pli49/Final-Year-Project/README.md

# ENEL400-ENMT401-EN14

My contribution for this project was desplayed in the Pengcheng-Liu-Mic-part folder.
