pli49/Final-Year-Project/Reports/Final Report/AppendixA.tex

\begin{figure}[H]
\centering
\noindent 
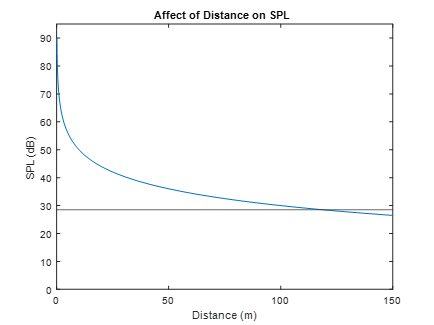
[picture p1: Reports/Final Report/images/sim1.png]

\caption{Attenuation with distance}
\label{fig:distAtt}
\end{figure}

\begin{figure}[H]
\centering
\noindent 
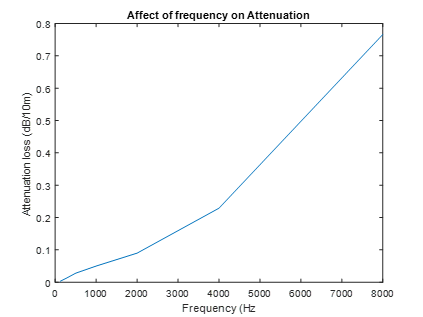
[picture p2: Reports/Final Report/images/sim2.png]

\caption{Attenuation due to atmosphere}
\label{fig:distAtt}
\end{figure}

\begin{figure}[H]
\centering
\noindent 
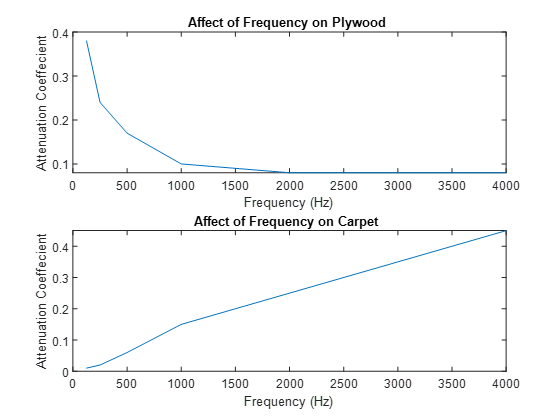
[picture p3: Reports/Final Report/images/sim3.png]

\caption{Attenuation due to materials}
\label{fig:distAtt}
\end{figure}
