pli49/Final-Year-Project/Reports/Final Report/AppendixB.tex

\begin{table}[H]
\captionsetup{singlelinecheck = false, format= hang, justification=raggedright, font=footnotesize, labelsep=space}
\caption{Limiting factors of frequency}
\begin{adjustbox}{max width=\textwidth}
\begin{tabular}{p{7.95cm}p{7.95cm}}
\hline
\multicolumn{1}{|p{7.95cm}}{Limiting factor } & 
\multicolumn{1}{|p{7.95cm}|}{Frequency Constraint} \\ 
\hline
\multicolumn{1}{|p{7.95cm}}{Speaker} & 
\multicolumn{1}{|p{7.95cm}|}{>700 Hz and <11 kHz} \\ 
\hline
\multicolumn{1}{|p{7.95cm}}{Noise } & 
\multicolumn{1}{|p{7.95cm}|}{>1600 Hz} \\ 
\hline
\multicolumn{1}{|p{7.95cm}}{Porous Materials} & 
\multicolumn{1}{|p{7.95cm}|}{<250 Hz} \\ 
\hline
\multicolumn{1}{|p{7.95cm}}{Reflective Material} & 
\multicolumn{1}{|p{7.95cm}|}{>1 kHz} \\ 
\hline
\multicolumn{1}{|p{7.95cm}}{Air Attenuation } & 
\multicolumn{1}{|p{7.95cm}|}{<15 kHz} \\ 
\hline
\end{tabular}
\end{adjustbox}
\label{tab:limiting_factors_frequency}
\end{table}
