pli49/Final-Year-Project/Reports/Final Report/AppendixC.tex

\begin{figure}[H]
\centering
\noindent 
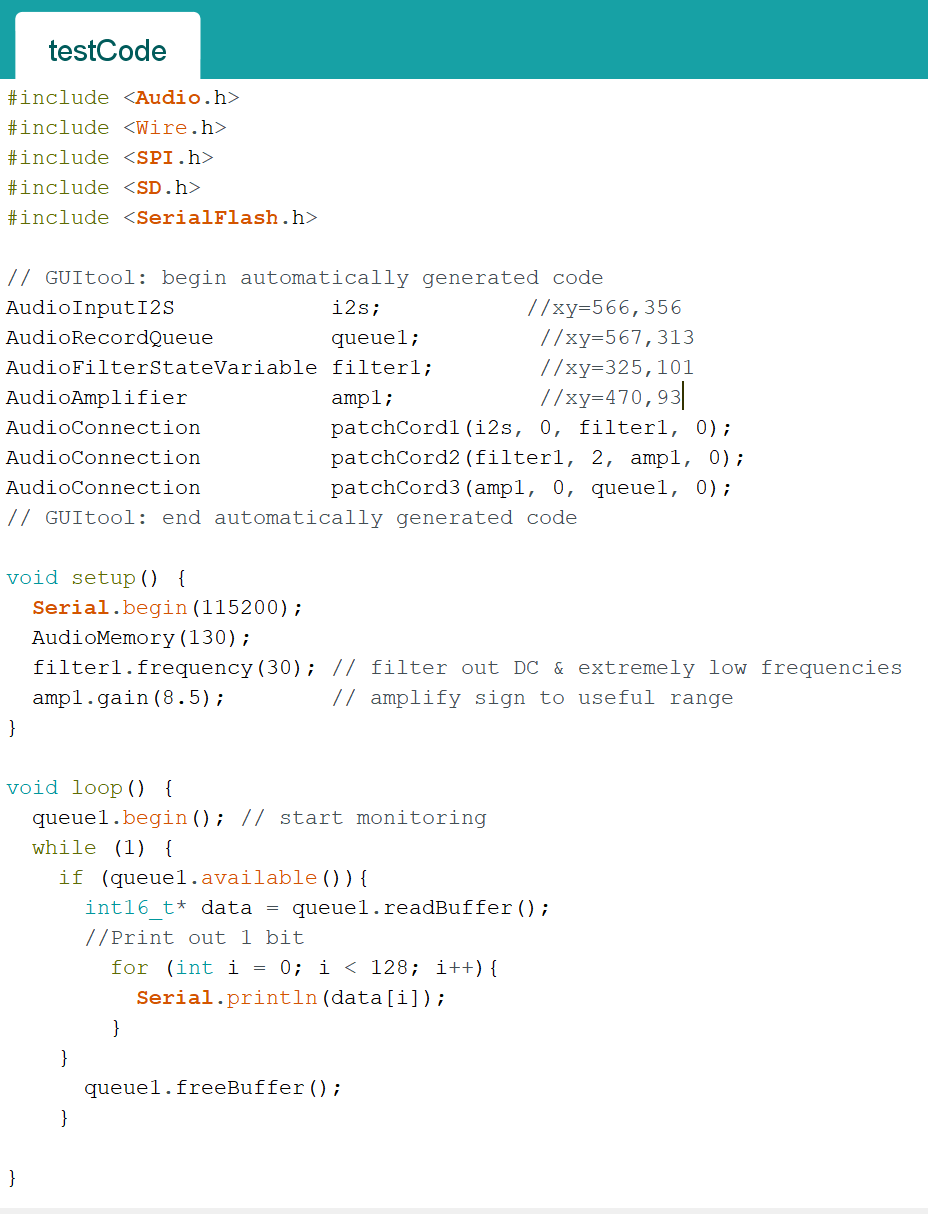
[picture p4: Reports/Final Report/images/testCode.PNG]

\caption{Test Code using Queue function}
\label{fig:testCode}
\end{figure}
