pli49/Final-Year-Project/Speaker/Final Report/Laurence_Section.tex

% !TeX spellcheck = en_AU-EnglishAustralia
% Preamble
\documentclass[12pt, a4paper]{article}
\usepackage[utf8]{inputenc}
%\usepackage[english]{babel}

\usepackage{indentfirst}
\usepackage{rotating, graphicx}
\usepackage{geometry}
\usepackage{hyperref}
\usepackage{amsmath}
\usepackage{amssymb}
\usepackage{gensymb}
\usepackage{caption}
\usepackage{array}
\newgeometry{vmargin={30mm}}
\usepackage[toc,page]{appendix}

\setlength{\oddsidemargin}{0mm}
\setlength{\evensidemargin}{-14mm}
\setlength{\marginparwidth}{0cm}
\setlength{\marginparsep}{0cm}
\setlength{\headheight}{0mm}
\setlength{\topmargin}{2mm}
\setlength{\headsep}{0cm}
\setlength{\textheight}{240mm}
\setlength{\textwidth}{160mm}
\setlength{\topskip}{0mm}
\setlength{\footskip}{10mm}
\setlength{\parindent}{8ex}

\title{The Speaker System}	
\author{Laurence Prins}
\date{25.10.2021}
\usepackage[style=ieee]{biblatex}
\addbibresource{References.bib}

\begin{document}
\section{Exec Sum}
Office workers can spend up to ninety-thousand hours of their life at work. It is important that these office environments are as ergonomic as possible for the sake of the workers’ health and well-being. Wellnomics develop systems for improving office space workers health and well-being. Wellnomics are developing a device that will attempt to map an indoor space using audio technology. Use of the device will allow better understanding of how to structure the office layout for improving the environment. \\

The goal of the project was to lay the foundations for using audio technology to measure distance. The user requirements were: the system must use sound to measure distance, a model should be built to estimate device position, the devices should be low cost, the devices should be low power, the devices should be small and the designed system should be robust to noise. \\

The work was split up into four areas: the sound to produce, the speaker system, the microphone, and the area mapping. Each of these areas required research, simulations and prototyping to develop the final systems. \\

Research into the sound to play found the most common forms of noise within an office space, the absorbtion and reflection of various office space materials and the frequency response of the speaker and microphone. Using the information it was concluded that the best frequency range for the system is between 1600Hz and 11kHz. \\

A system for the speaker needed to be designed such that the output was a loud and accurate tone. Development of the speaker system involved production of hardware for making the tone, and development of the software to produce sinusoids. The final system can play single tones and linear sweeps of between 600Hz and 20kHz, the full range of the speaker. \\

The microphone used in this project is a small I2S MEMs microphone. Research was first conducted on how to make the microphone work and understand and use the output. Methods were theorised for conducting distance measurements with the microphone. Unfortunately, due to the speed of the FFT there would be an uncertainty of 3.773 metres. \\

Work was conducted on how to measure distance. It was concluded that the best method is to use a linear FM sweep and use of convolution to detect the start of the waveform. Devices utilising a "virtual wall" could then asynchronously measure distance. Simulations were done on generation of 2D and 3D mesh generation for mapping the devices once measurements are obtained. \\

Although no distance measurements were conducted using the devices in this project, the framework is all set up for future development. \\
\pagebreak
\section{Laurence Prins}
\subsection{Introduction and Background}
A key aspect of measuring distance with sound is the ability to reliably reproduce a high power and accurate audio tone. The tone produced should have a high SPL output such that it can be detected from far away, and should be accurate such that the tone can be extracted at the receiver in the midst of background noise. The designed system should also have an easy to use control system for testing a wide range of tones. This section of the report covers the development of the speaker system, looking at the speaker and amplifier, the creation of a sine wave and code development for controlling the system.\\
\subsection{Hardware}
\subsubsection{Speaker}
The used speaker for the system is the AS01508MS-SP11-WP-R as it was supplied by the sponsor. This has the specifications shown in Table \ref{tab:L_speakerSpecs}.  The system designed for the speaker needed to supply at least 0.7W, and to get the highest SPL from the speaker it needs a supply of at least 1W. Running the speaker for long periods at the 1W input power could cause damage, however the speaker is not be producing tones for long so this would be irrelevant for the design. \\

Other characteristics of importance for the speaker include the impedance and sensitivity, which are both functions of frequency. Each component selected in the design for the speaker system took into account this frequency response, selecting components with a similar frequency response. \\

\begin{table} [!htb]
	\caption{Key speaker specifications, source: \cite{speakerDatasheet}}
	\label{tab:L_speakerSpecs}
	\centering
	\begin{tabular}{ |c|c|c| }
		\hline
		Parameter & Value & Unit \\ 
		\hline
		Rated Input Power & 0.7 & W \\ 
		Max Input Power & 1 & W \\ 
		Impedance & 8 $\pm$ 15\% & Ohms \\
		Sensitivity (SPL@2V/10cm) & 89 $\pm$ 3 & dB \\
		\hline
	\end{tabular}
\end{table}

\subsubsection{Amplifier}
The output from the MCU is a 3.3V peak waveform with a 0.04mA current, this is a much lower power output than what is needed by the speaker. An amplifier is used to increase the power of the output waveforms from the MCU. \\

There were several options considered for the amplifier, class A, class B, class AB and class D each with their own advantages and disadvantages. Ultimately, the best amplifier for the system is the class D amplifier. This is because it is more efficient than the other options (theoretically up to 100\%), allowing the speaker to be driven to its peaks. Efficiency is also important to meet the low power draw user requirement of the system. \\

The chosen amplifier is the class D PAM8403 audio amplifier with the specifications shown in Table \ref{tab:L_ampSpecs}. The amplifier was chosen as it is up to 90\% efficient outputting up to 1.4W for the 8$\Omega$ load. The amplifier gets its efficiency as it uses differential outputs and sinusoidal PWM to pull each leg of the speaker between 0 and Vcc, working in an operation like an H-bridge. \\
\begin{table} [!htb]
	\caption{Key amplifier specifications, source: \cite{amplifierDatasheet}}
	\label{tab:L_ampSpecs}
	\centering
	\begin{tabular}{ |c|c|c| } 
		\hline
		Parameter & Rating & Unit \\ 
		\hline
		Input Voltage & -0.3 to +0.3 & V \\ 
		Supply Voltage & 5.0 & V \\ 
		Output Power for 8 $\Omega$ Load and 5V Supply & 1.4 & W \\
		\hline
	\end{tabular}
\end{table}

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

The MCU cannot easily produce a sinusoidal tone as it does not include a digital to analogue converter. To get around this there were several options considered including purchasing an off-board DAC, purchasing a new MCU, or using code to produce sinusoidal PWM. Ultimately, the best option was to use parts that were easily obtained to meet the low-cost user requirement, that meant using sinusoidal PWM. By generating a sinusoidal PWM signal, and passing the waveform through a low pass filter, a good estimate of a sine wave can be produced. \\
\subsubsection{Generating Sinusoidal PWM}
\label{sec:L_Sinusoidal PWM}
First the sinusoidal PWM waveform needs to be generated at the MCU output pin. This was done using code. A continuous sinusoidal waveform of period, $T_s$, is split up into $L$ discrete intervals. At each of these intervals, the duty cycle increased or decreased by $\frac{100\%}{2^m}$ where m is the resolution of the PWM generator. 100\% duty cycle is equal to $2^m - 1$, which is set when the sinusoid is at its peak, and the minimum value corresponding to 0\% duty cycle is 0 which is set when the sinusoid is at its minimum. The 50\% duty cycle is then $(2^m-1)/2$ which is the cross-over point of the sinusoid. These values are put into a sine look up table of length L. Figure \ref{fig:L_Sinusoidal_PWM} shows the sinusoid being split up into L discrete intervals and the corresponding duty cycles. \\

\begin{figure} [!htb]
	\hfill\hspace{\fill}
	\caption{Sinusoidal PWM generation}
	\label{fig:L_Sinusoidal_PWM}
\end{figure}
To set the rate which the LUT is indexed, a counter and an interrupt timer is used. At each interrupt period, $\tau$, a step of $\Delta$ is added to the current counter value. Once the counter exceeds the maximum counter value, $M$, the counter is reset with remainder carried and the LUT is indexed by one for each amount of $\Delta$ the count is above M. Figure \ref{fig:L_Counter} shows the visualisation of the counter. 
\begin{figure} [!htb]
	\captionsetup{justification=centering}
	\hfill\hspace{\fill}
	\caption{Counter with max value M, it takes n$\Delta$ counts to exceed M}
	\label{fig:L_Counter}
\end{figure}

It takes $n$ lots of $\Delta$ to exceed $M$ therefore:
\begin{equation}
	n\times\Delta \ge M \implies n = \frac{M}{\Delta}
	\label{eqn:M/D}
\end{equation}
The interrupt is being called every $\tau$ seconds and so the time it takes per increment of the LUT is $n\times T$. There are $L$ elements in the LUT so, the period of the sine wave is thus:
\begin{equation}
	T_s = n\times \tau\times L
\end{equation}
Which can be written in terms of frequency:
\begin{equation}
	f_s = \frac{1}{n\tau L}
\end{equation}
And in terms of the step size by substituting equation \ref{eqn:M/D}:
\begin{equation}
	f_s(\Delta) = \frac{\Delta}{M\tau L}
\end{equation}

The frequency of the output sine is now a function of the step size $\Delta$ and thus sinusoidal waveforms of selectable frequencies can be produced. The equation can be re-arranged to find any values of $\Delta$ that gives a corresponding sinusoidal output frequency, which is exactly how the code decides the output frequency. \\

The values of M and $\tau$ were determined through experimentation, where if the interrupt rate was too high then the interrupt function is too slow and so the frequency gets capped at less than 20kHz. Having this value too high would result in the same problem. The value for $f_{PWM}$ was chosen as such as it allows the PWM frequency to be fully filtered out leaving behind just the sinusoidal component. The value of m is dependent on the PWM frequency and vice-versa, however the Teensy can re-map values passed to it, so the selection of m is irrelevant and a value of 8. Finally, the LUT was selected as $2^8$ to match the PWM resolution used. The values selected for the sinusoidal PWM generation parameters are summarised in Table \ref{tab:L_sinusoidalPWM}.\\
\begin{table} [!htb]
	\caption{Parameters used for sinusoidal PWM generation}
	\label{tab:L_sinusoidalPWM}
	\centering
	\begin{tabular}{ |c|c|c|c| }
		\hline
		Parameter & Description & Value & Units \\ 
		\hline
		M & Counter Maximum & 100 & - \\ 
		$\tau$ & Interrupt Period & 5 & $\mu$s \\ 
		L & LUT Size & $2^8$ & - \\
		$f_{PWM}$ & PWM Frequency & $2^8\times f_s$ & Hz\\
		m & PWM Resolution & 8 & - \\
		\hline
	\end{tabular}
\end{table}

\subsubsection{Filtering the Sinusoidal PWM Signal}
\label{sec:L_Low_Pass_Filter}
To filter the sinusoidal PWM signal, a second order LC Butterworth filter is used. The filter connects to the output pin on the MCU as shown in Figure \ref{fig:L_LPF}. The values selected for the LPF gives the filter a cut-off frequency of 28kHz. 28kHz was chosen as it higher than the maximum frequency of the speaker but is also able to fully filter out the PWM carrier frequency. \\

The filter also contains a 67$\mu$F electrolytic capacitor. This is because the output sinusoidal PWM waveform generated is shifted with a maximum value of 3.3V and a minimum value of 0V. To get the speaker driven to the peaks in its motion it needs to be fed a waveform centred about DC. So using a DC blocking capacitor shifts the output sine waveform from the LPF back to DC. The capacitor and the 10k$\Omega$ resistor at the entrance of the amplifier form a passive bandpass filter with a passband of between 0.237Hz and 297Hz depending on the position of the variable resistor wiper, and a stopband of 28kHz. \\
\begin{figure} [!htb]
	\hfill\hspace{\fill}
	\caption{Second order LC low pass filter with a cut-off frequency of 28kHz}
	\label{fig:L_LPF}
\end{figure} 

\subsubsection{Linear FM Sweep (Chirp)}
\label{sec:L_Chirps}
The speaker is required to play a linear FM sweep as used in the convolution method of measuring distance. To produce a linear FM sweep, or chirp, the continuous function is described by:
\begin{equation}
	f(t) = ct + f_0
	\label{eqn:Chirp1}
\end{equation}
Where $f_0$ is the initial frequency, and c is the chirp rate, calculated as:
\begin{equation}
	c = \frac{f_1 - f_0}{T_c}
\end{equation}
Where $f_1$ is the final frequency and $T_c$ is the sweep or chirp time. \\

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

To differentiate serial inputs, the function needs to be input between $<$ and $>$. The code waits till it sees the $<$ and will extract all the data from between the two arrows. Using this method allows the user to run several inputs at once in one serial line. When it comes to playing a tone, this allows the ability to run multiple one after the other essentially chaining waveforms together. \\

\subsubsection{Waveforms}
The code loop is combined with "waveforms", where each waveform is a struct stored in a singly linked list. Each waveform contains an an initial frequency, a final frequency, a wave time and a shape (p for square or s for sine). When the waveform is created it is given a unique identifier and is stored at the head of a singly linked list shown in Figure \ref{fig:L_Waveforms}. Waveforms in the list can be displayed, edited, deleted, played or even looped using functions outlined in Table \ref{tab:L_transmitterInteractions} in Appendix \ref{sec:l_append}. \\

\begin{figure} [!htb]
	\hfill\hspace{\fill}
	\caption{Waveforms in a linked list data structure}
	\label{fig:L_Waveforms}
\end{figure} 

Waveforms allow a convenient method of playing a wide range of tones quickly. For example, the user can create 10 waveforms of increasing frequency and test each one. After testing each one they could identify the best for the use case and keep on testing that one, typing in an identifier instead of each waveform property each time. For quick testing however, functions were created which allows users to simply input all the waveform properties without having to create a waveform. The play tone functions are outlined in Table \ref{tab:L_toneInteractions} in Appendix \ref{sec:l_append}. \\

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

\begin{figure} [!htb]
	\captionsetup{justification=centering}
	\hfill\hspace{\fill}
	\caption{Speaker hardware setup, the labelled sections are - A: Teensy 4.0 MCU dev board, B: LPF and variable resistor volume knob, C: class D audio amplifier breakout board, D: Speaker}
	\label{fig:L_Hardware}
\end{figure} 

A wide range of tones were tested with the speaker, both square and sinusoidal. The system was capable of playing square tones up to 9kHz but not above as the extra harmonics were fully filtered. As the best range of the speaker is at 10kHz, this was the most tested waveform. The following results section shows the generation of a 10kHz tone from transmitter to receiver. \\

The waveform is first created and played shown in Figure \ref{fig:L_Create_Waveform}. The 1280 number shown is the step size required to play the 10kHz tone. The sinusoidal PWM waveform is then generated at the audio output pin shown in Figure \ref{fig:L_Create_Waveform}. The waveform has a lot of ripple as the PWM frequency is so high (2.54MHz). \\

The waveform is then passed through the LPF and DC blocking capacitor resulting in the waveforms shown in Figure \ref{fig:L_Shifted_Waveform}. \\

The waveform then travels through the medium. Figure \ref{fig:L_Output} shows the spectrum of the output audio waveform generated in MATLAB and the power spectral density of the output waveform generated using an auto regressive Yule-Walker method. The audio clip was recorded in the students bedroom on a quiet afternoon, as such there is little noise. \\

\begin{figure} [!htb]
	\captionsetup{justification=centering}
	\hfill\hspace{\fill}
	\hspace{\fill}
	\caption{Left: A 10kHz tone is created and given the unique identifer "0". The waveform is then played using the play function: $"<p(0)>"$. Right: The waveform as generated at the audio output pin.}
	\label{fig:L_Create_Waveform}
\end{figure}

\begin{figure} [!htb]
	\captionsetup{justification=centering}
	
	
	\caption{Left: the shifted waveform as seen at the exit of the LPF. Right: the waveform as seen at the exit of the DC blocking capacitor}
	\label{fig:L_Shifted_Waveform}
\end{figure}

\begin{figure} [!htb]
	\captionsetup{justification=centering}
	
	
	\caption{Left: the output audio spectrum. Right: the output power spectral density (PSD)}
	\label{fig:L_Output}
\end{figure}

\pagebreak
\subsection{Discussion}
The objective for the speaker system was to produce a system that can play a loud and accurate tone. Control for the system should be easily used to produce any desired tone within the speakers range. The system developed should meet as many of the user requirements as possible. \\

The system for generating waveforms works well. By utilising waveforms and using functions from within the serial interface, a wide range of tones were able to be quickly tested. In the testing phase with the other devices, using waveforms allowed ease of talking between devices. Use of waveforms could be useful in final product. The device could play a waveform and if no results are picked up, the device could move on and play another waveform. Devices could also be given unique waveforms, potentially allowing several devices to talk at the same time as each other. \\

The amplifier is a class D amplifier which means that the output is a square waveform. To compensate for this, an additional 2nd order LPF can be added to the legs of the speaker. However, the speaker itself acts as a low pass filter with a cut-off of 20kHz. This means that the only use of the filters will be for reducing electromagnetic interference and as a result were not implemented in the final system for the speaker. To improve on the reliability of the system however, these LPF should be implemented. \\

The final hardware design is big which means it does not meet the small design user requirement. However, as this system was just designed with testing in mind, it serves its purpose. The designed system is ultimately just a prototype and would need to be refined and polished. For future development, it is recommended to construct a PCB. The PCB should also address the use of the variable resistor as the current trim-pot variable resistor requires direct interaction with the hardware. Using a system that can control the output audio using code would be beneficial for further development of the system, allowing for freedom of control of the output audio power. \\

Development of the sinusoidal PWM system also took longer than it should have. It would make more sense in the final product to utilise a DAC chip or a MCU with an onboard DAC. This would result in a more accurate audio waveform which is what is necessary for measuring distance with sound and making the system robust to noise. If a DAC chip had been purchased from the start, that time could have been spent on other areas such as helping other group members on their development. \\

The system is fully capable of playing tones up to 20kHz, which is the full range of the speaker. This is however with a fast MCU with the 5$\mu$s interrupt (200kHz) used in creating the sinusoidal signal. For a slower MCU clock speeds, this might not be possible. As a result it is even more important for slower micros to use an off-board or on board DAC for generating the sinusoidal tone.\\

Most of the output signal is concentrated within the central 10kHz lobe as shown in Figure \ref{fig:L_Output}. The PSD shows this more clearly, where there is peak at lower frequencies due to background noise at the time of recording. Although, since the unit of the PSD is in dB, the noise is completely dominated by the output signal. The speaker system is therefore capable of playing accurate tones as the design requirements. Further testing would need to be conducted on the speaker system to identify the exact limitations of the system. \\

The prototype system for the speaker is complete and the framework has been laid to allow for ease of integration with the rest of the system. \\
\pagebreak
\subsection{For Appendix: Serial Inputs for Speaker System}
\label{sec:l_append}
Table \ref{tab:L_waveformInteractions} shows a list of accepted functions for creating and interacting with waveforms. \\

For example, to create a waveform that plays a 10kHz sinusoidal tone for 1 second, type "$<$n(10000,10000,1000,s)$>$" into the serial interface. This will create a new waveform and give it an identifier. To display the waveforms to find out what identifier the new waveform was given, can then type "$<$d(a)$>$" which will print out the list of waveforms. As this was the first waveform created after the initial one created on startup, typing "$<$p(1)$>$" will play the 10kHz tone. If it was actually desired to have a linear FM sweep between 7kHz to 10kHz over 250 ms, then the waveform can be edited using "$<$e(1,f0,7000,time,250)$>$". Typing "$<$d(a)$>$" will then display the new waveform. Playing the tone now will then play the linear FM sweep between 7kHz and 10kHz over 250ms instead of the 10kHz tone. \\
\begin{table} [!htb]
	\caption{Waveform interaction functions}
	\label{tab:L_waveformInteractions}
	\centering
	\begin{tabular}{ |m{0.25\textwidth}|m{0.35\textwidth}|m{0.4\textwidth}| } 
		\hline
		Serial Command & Description & Inputs \\ 
		\hline
		\hline
		\centering $<n(f0,f1,t,s)>$ & Creates a new waveform, gives it a unique identifier, and stores it at the head of the singly linked waveform list. & f0 = initial frequency [Hz]
		
		f1 = final frequency [Hz].
		 
		t = wave time [s].

		s = waveshape 
		
		[s = sinusoidal, p = square]. \\
		
		\hline
		\centering$<e(i,p1,v1,p2,v2,$
		\centering$…,pn,vn)>$ & Updates the specified waveform with the new values for the specified properties. & i = identifier of wave to edit.
		
		pn = property (f0, f1, time or shape).
		
		vn = new value. \\
		
		\hline
		\centering$<r(i)>$ & Deletes the specified waveform. & i = identifier of wave to remove.
		
		If i = a then deletes all waveforms in the linked list instead. \\
		\hline
		\centering$<d(i)>$ & Prints all the properties of the specified waveform into the serial interface. & i = identifier of wave to display.
		
		If i = a then displays all waveforms in the linked list instead.\\
		\hline
		\centering$<p(i)>$ & Plays the specified waveform through the audio output pin, 
		if f0 $\neq$ f1 then this will play a linear FM sweep between those frequencies. & i = identifier of wave to play. \\
		
		\hline
		\centering$<l(i)>$ & Plays the specified waveform through the audio output pin until the serial reads a new input. & i = identifier of wave to loop. \\
		\hline		
	\end{tabular}
\end{table}
\pagebreak

Table \ref{tab:L_toneInteractions} shows a list of accepted functions for playing tones without using waveforms. \\

For example, to play a 10kHz tone over 1 second, type "$<$pt(10000,10000,1000,s)$>$" will play that tone. Typing "$<$pt(7000,10000,250,s)$>$" will play the linear sweep again. This method allows for quick testing of different waveforms, however requires more typing in the long run. If the user is wanting to repeatedly test a specific tone, they should use a waveform instead. \\
\begin{table} [!htb]
	\caption{Play tone functions}
	\label{tab:L_toneInteractions}
	\centering
	\begin{tabular}{ |m{0.25\textwidth}|m{0.35\textwidth}|m{0.4\textwidth}| } 
		\hline
		Serial Command & Description & Inputs \\ 
		\hline
		\hline
		\centering $<pt(f0,f1,t,s)>$ & Plays a tone with the specified properties through the audio output pin. if f0 $\neq$ f1 then this will play a linear FM sweep between those frequencies. & f0 = initial frequency [Hz]
		
		f1 = final frequency [Hz].
		
		t = wave time [s].
		
		s = waveshape 
		
		[s = sinusoidal, p = square]. \\
		
		\hline
		\centering $<lt(f0,f1,t,s)>$ & Plays a tone with the specified properties through the audio output pin until the serial reads a new input. & f0 = initial frequency [Hz].
		
		f1 = final frequency [Hz].
		
		t = wave time [s].
		
		s = waveshape 
		
		[s = sinusoidal, p = square] \\
		
		\hline
		
	\end{tabular}
\end{table} \\
\pagebreak
Table \ref{tab:L_transmitterInteractions} shows a list of functions for interacting with the transmitter object. \\

For example, to see what properties the transmitter has, type "$<$TxDisp()$>$" into the serial interface. This will print all the transmitter properties into the serial monitor. If the user wants to update the waveform from waveform 0 to waveform 1 type "$<$TxCfg(waveform, 1)$>$". If the waveform is deleted from the linked list, then the transmitter still has knowledge of the waveform, so transmitting will play the old waveform. \\

\begin{table} [!htb]
	\caption{Transmitter functions}
	\label{tab:L_transmitterInteractions}
	\centering
	\begin{tabular}{ |m{0.25\textwidth}|m{0.35\textwidth}|m{0.4\textwidth}| } 
		\hline
		Serial Command & Description & Inputs \\ 
		\hline
		\hline
		\centering $<$TxCfg(p1,v1,p2,v2,
		…,pn,vn $>$ & Configure the transmitter with the specified values. & i = identifier of wave.
		
		pn = property (pin, waveform, or delay).
		
		vn = new value. \\
		\hline
		\centering $<$TxDisp()$>$ & Displays all the current properties of the transmitter. & N/A \\
		\hline
		\centering $<$Tx()$>$ & \begin{enumerate}
			\item Pulls the transmitter pin high.
			\item Transmits the specified waveform through the audio output pin.
			\item Waits delay period.
			\item Pulls pin low.
		\end{enumerate} & N/A \\
		\hline
	\end{tabular}
\end{table}
\end{document}
