pli49/Final-Year-Project/Meetings and Timesheet/meeting_15_06_08_21.docx

Meeting Room: link 301

Meeting date: 06/08/21

Meeting time: 1:00-1:34

Meeting attendees: Kevin Taylor, Bill Liu, Laurence Prins, Aryan Srivastava, Tobey Bourke, Shayne Crimp, Diego Ramirez.

Meeting content

Bill

- Working on the I2S break out board.
- Problem encountered – mic not sensitive enough.
- Solution – record the sound and play it back

Toby

Laurance

Aryan
