pli49/Final-Year-Project/Sound/FYP/Sound/GreenZone.docx

Absorptive

Speaker

Reflective

Noise

Atmospheric Attenuation

1600 Hz -> 11kHz
