pli49/Final-Year-Project/Sound/FYP/Sound/Noise.pptx

## Noise

## Ambient Noise

Source | Typical Frequency (Hz)
Computers | 350
Printers | 270-540
Air Conditioning | 31.5-62
Talking | 125
Vehicles | 1000

## Waveform Interactions

- Constructive and Destructive Interference
- Beats

## Filtering Signals

- FFT
- Passive Filters
- Active filters

## FFT

- Fast Fourier Transform
- Separates frequencies into Individual components

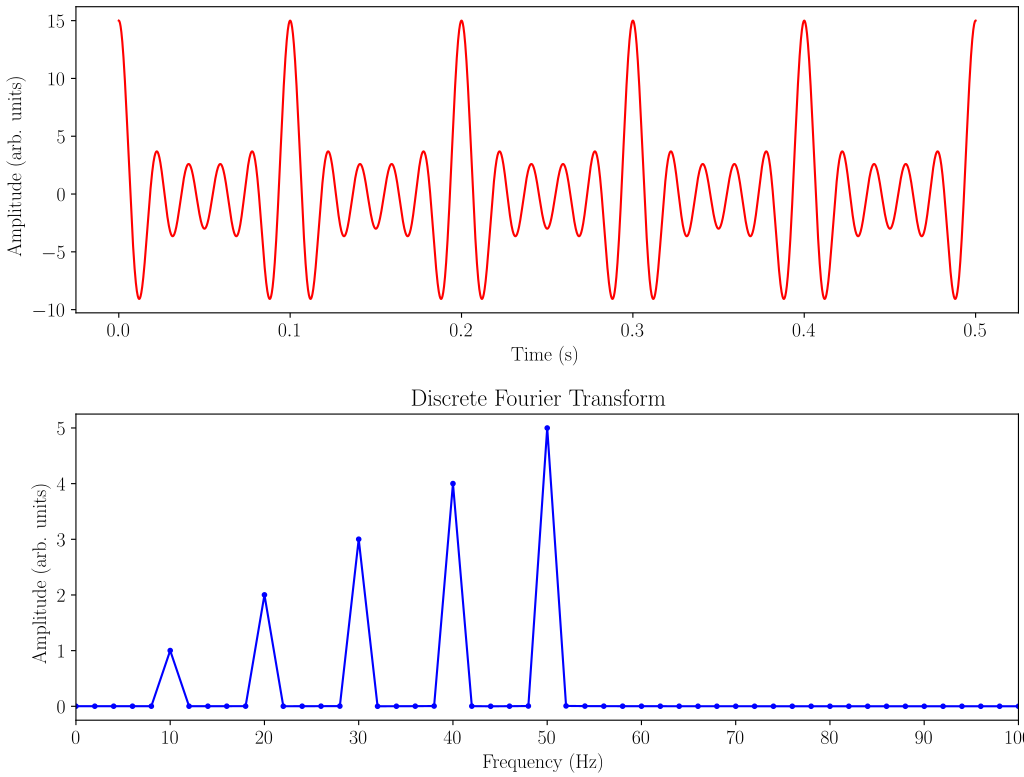
[picture p85: figure]

## Bandpass Filters

- Filter used to isolate a certain Frequency Band

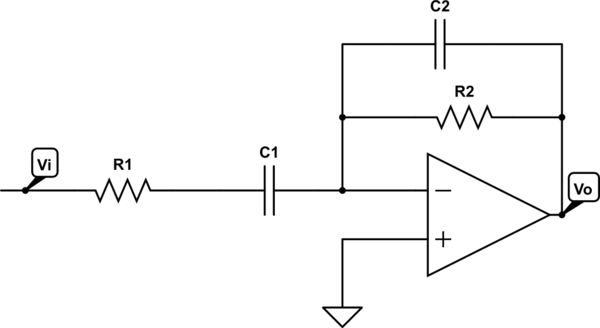
[picture p86: figure]
Active band pass filter cutoff frequencies - Electrical Engineering Stack Exchange
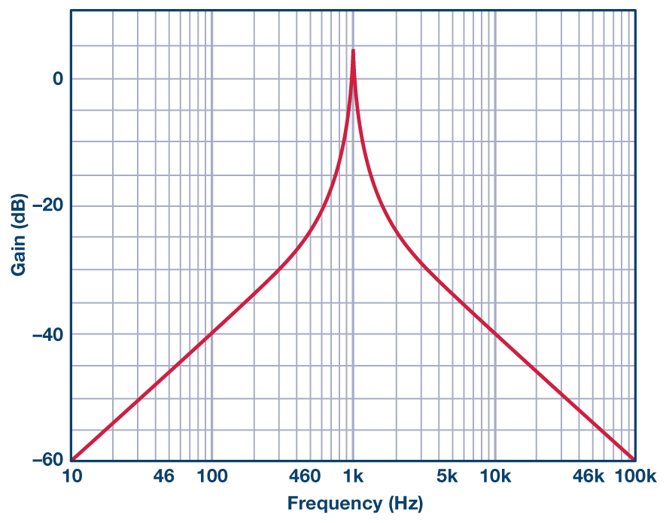
[picture p87: figure]
Phase Response in Active Filters | Analog Devices

## Second Order and First Order

- Second Order filters : Sallen Key Filter
- Higher dB/decade roll-off

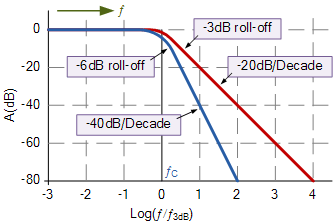
[picture p88: figure]
Second Order Filters | Second Order Low Pass Filter

## Multipath

- Multiple receptions of the same wave
- Due to reflections and absorptions

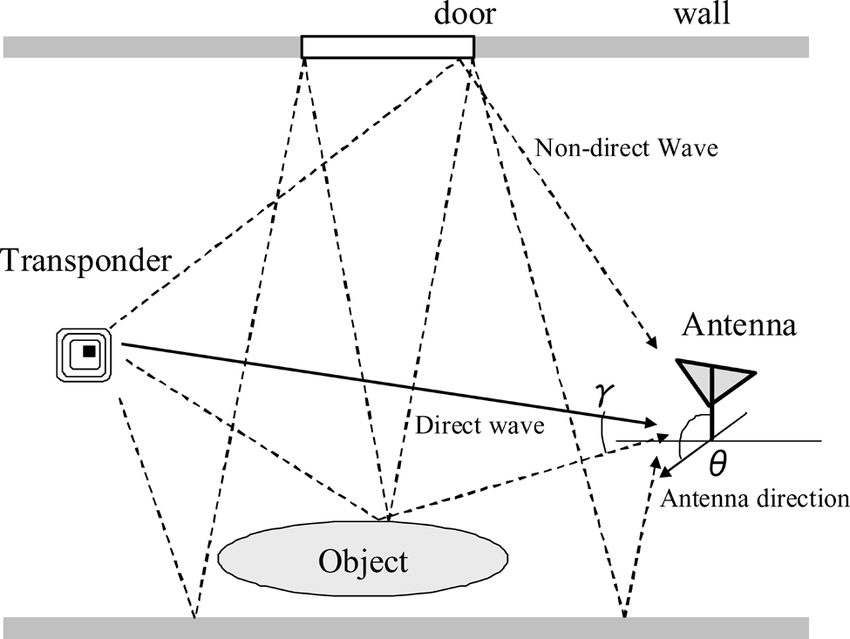
[picture p89: figure]
