pli49/Final-Year-Project/Sound/FYP/Sound/Research.docx

Research

Ultrasonic Sensors

Use high frequency waves.

Reflection sensing

Bandpass filtering

Small Range

Frequency spectra in Offices

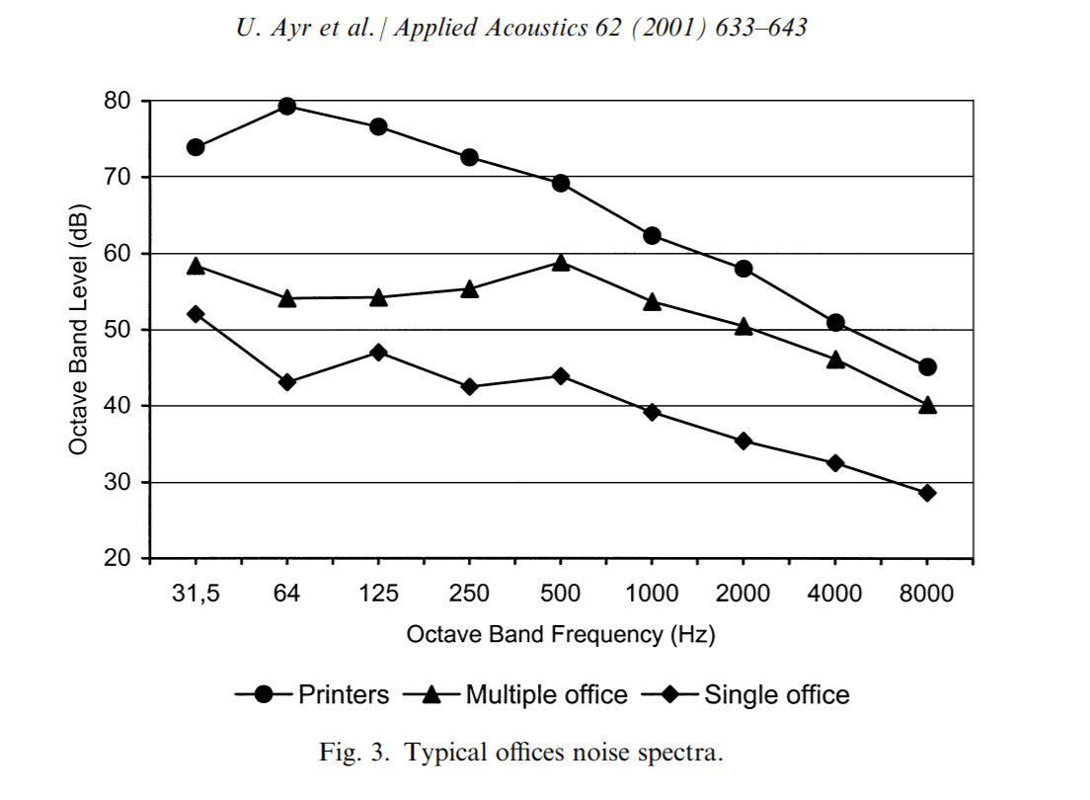
[picture p90: figure]
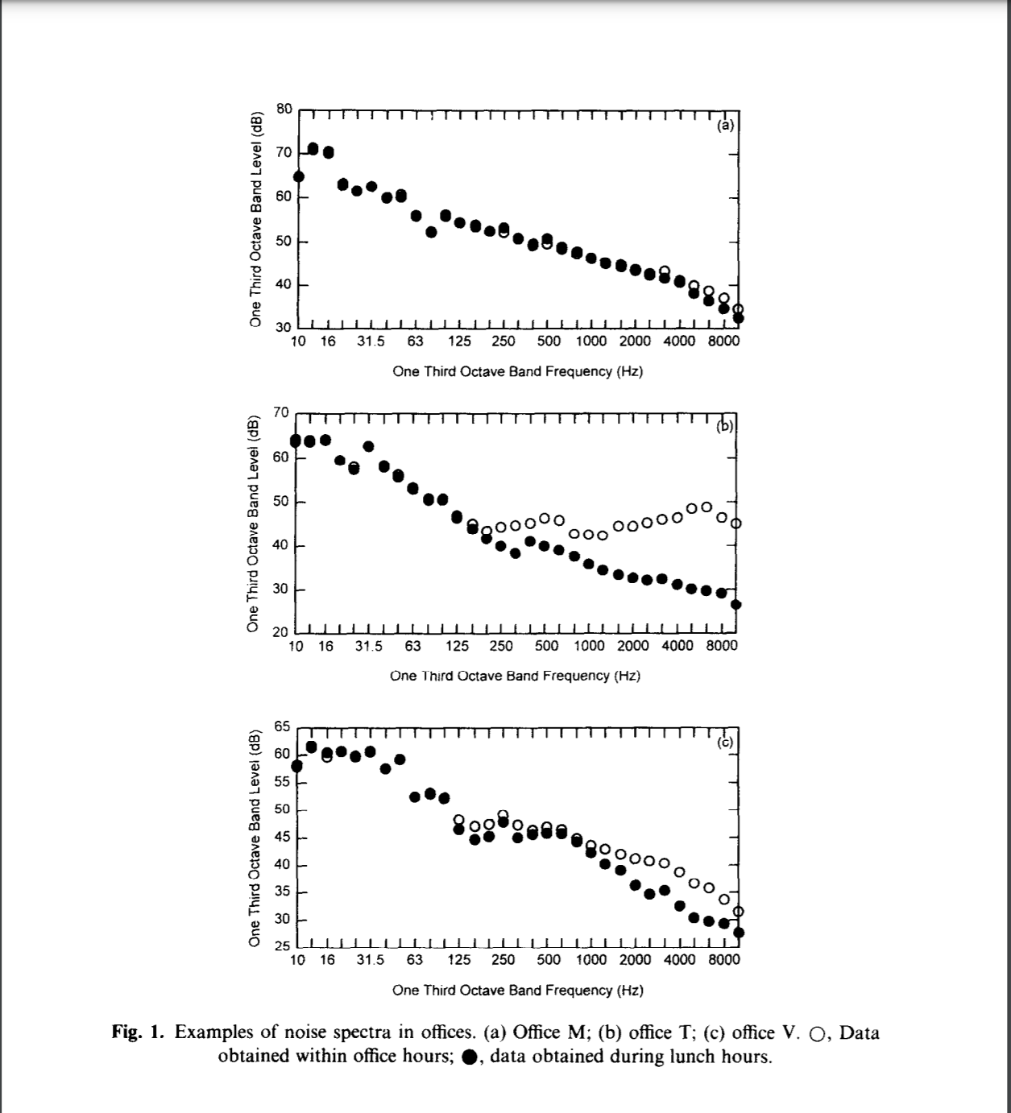
[picture p91: figure]
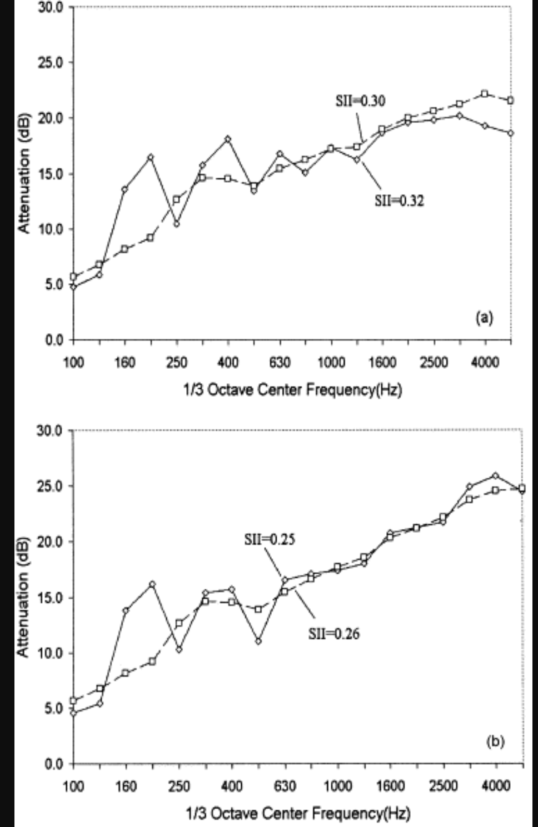
[picture p92: figure]
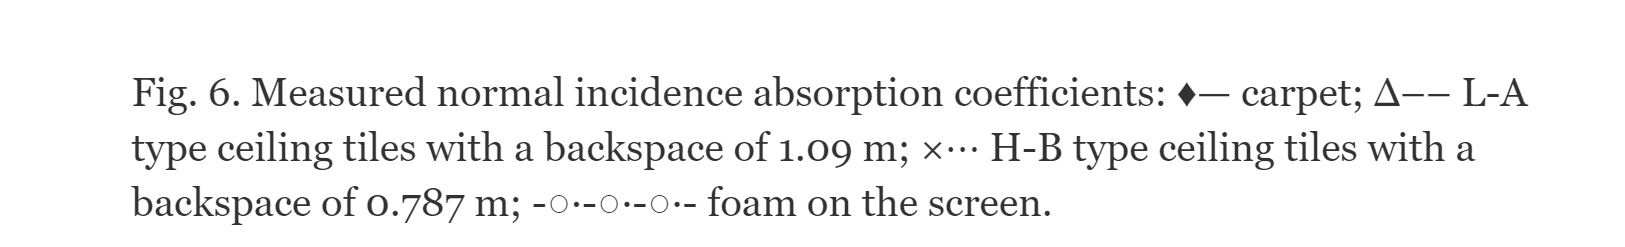
[picture p93: figure]
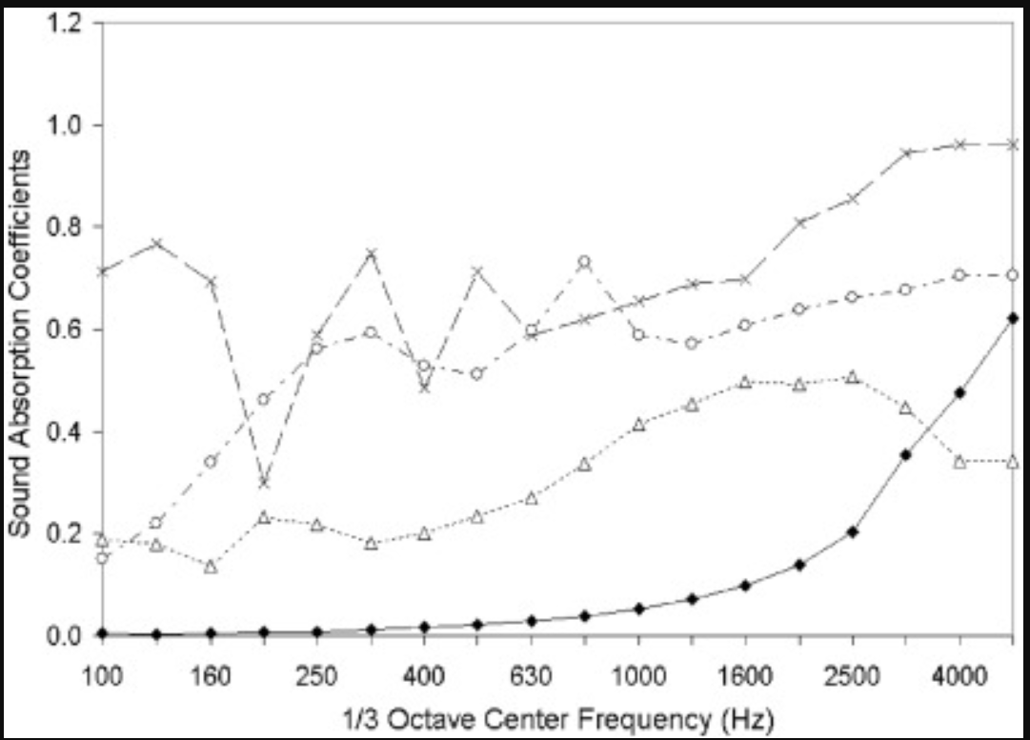
[picture p94: figure]
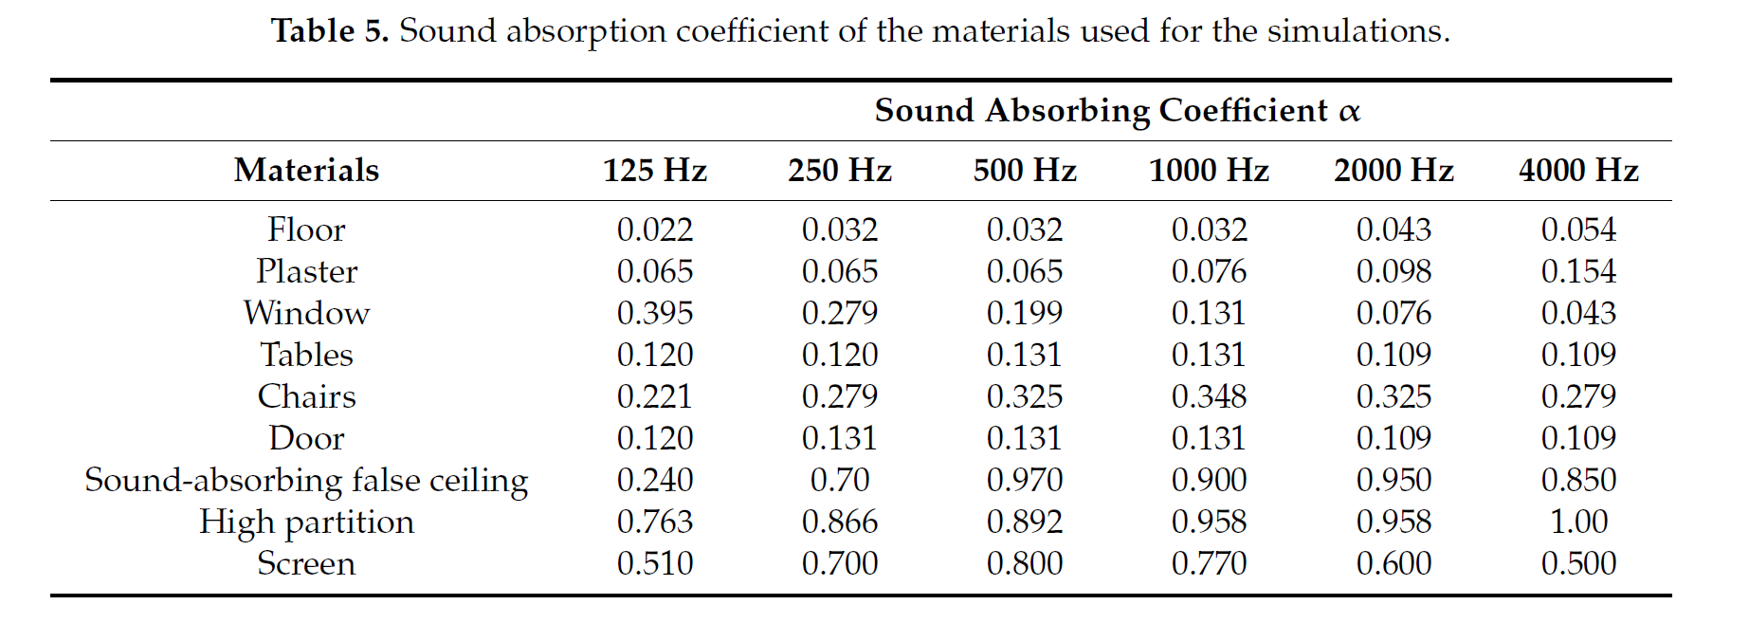
[picture p95: figure]

Testing

Fixed distance/Varying frequency/ with/without barriers

Fixed frequency/Varying distance with/without barriers

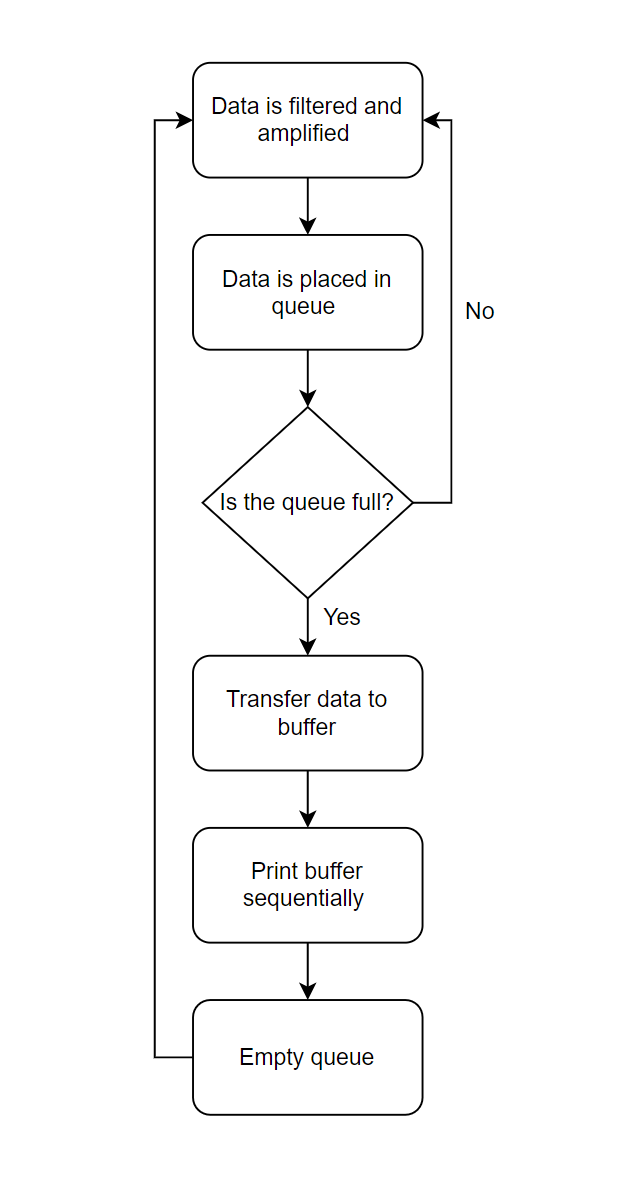
[picture p96: figure]
