pli49/Final-Year-Project/Sound/FYP/Sound/Sound.pptx

## Sound

## Measurement

- Sound is measured in dB
- More convenient due to large variations in pressure, intensity and power
- SPL is the Sound Pressure Level.
- SPL=20log_10 (ρ/(ρ_(ref)))

## Maximum Distance

- Frequency Response (Speaker) and Noise Floor (Microphone)
- Noise Floor=Reference Signal −SNR
- SPL_2 =SPL_1 −20log_10 ((r_2)/(r_1))
- r_2 ≈118m
- Only considers the attenuation due to distance.

## Attenuation

- Attenuation is the loss of energy as the a soundwave passes through a medium
- 3 main concerns
  - Sound attenuation through the air
  - Sound absorption via barriers
  - Sound transmission loss via barriers

## Attenuation in the Air

- Sound energy dissipated as heat as soundwave travels
- Higher frequency have more oscillations and attenuate quicker
- Temperature and Humidity
- Proportionality table

Parameter | Relationship with attenuation (in Air)
Frequency | Proportional
Temperature | Inversely Proportional
Humidity | Inversely Proportional
Distance | Proportional

## Absorption

- Absorptive

- Drapes, carpets
- Porous materials with airflow
- More attenuation as frequency rises.

- Reflective

- Plywood, plaster, concrete
- Little airflow
- More attenuation as frequency falls

## Sound Transmission Loss

- Sound energy loss when travelling through a barrier
- Very large in most cases
- STC, Sound transmission class
- Standardized measurement averaged across multiple frequencies

## Considerations

- Chosen frequency must be chosen with the following in mind
  - Distance between devices
  - Humidity and temperature of environment
  - Types of barriers present in environment
- Considerations still need to be looked into:
  - Noise
  - Noise filtering
