pli49/Final-Year-Project/Sound/FYP/Sound/Wellnomics Indoor Positioning System.pptx

## Wellnomics Indoor Positioning System

By Aryan Srivastava

## Sound

- SPL
  - Attenuation
  - Hardware
  - Noise
- Frequency

## Hardware - Speaker


## Hardware - Mic

## Attenuation - Distance

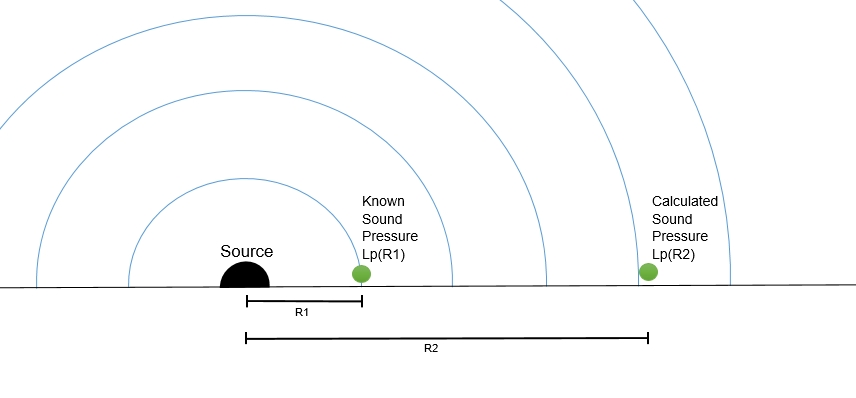
[picture p99: figure]

- Inverse Square Law
  - Lp(R2) = Lp(R1) - 20log(R2/R1)
- Noise Floor (Mic) : 28.5 dB
- Max theoretical distance : 118 m

## Distance Attenuation

## Attenuation - Atmospheric

- Attenuation due to atmospheric friction.
- Proportional to Frequency

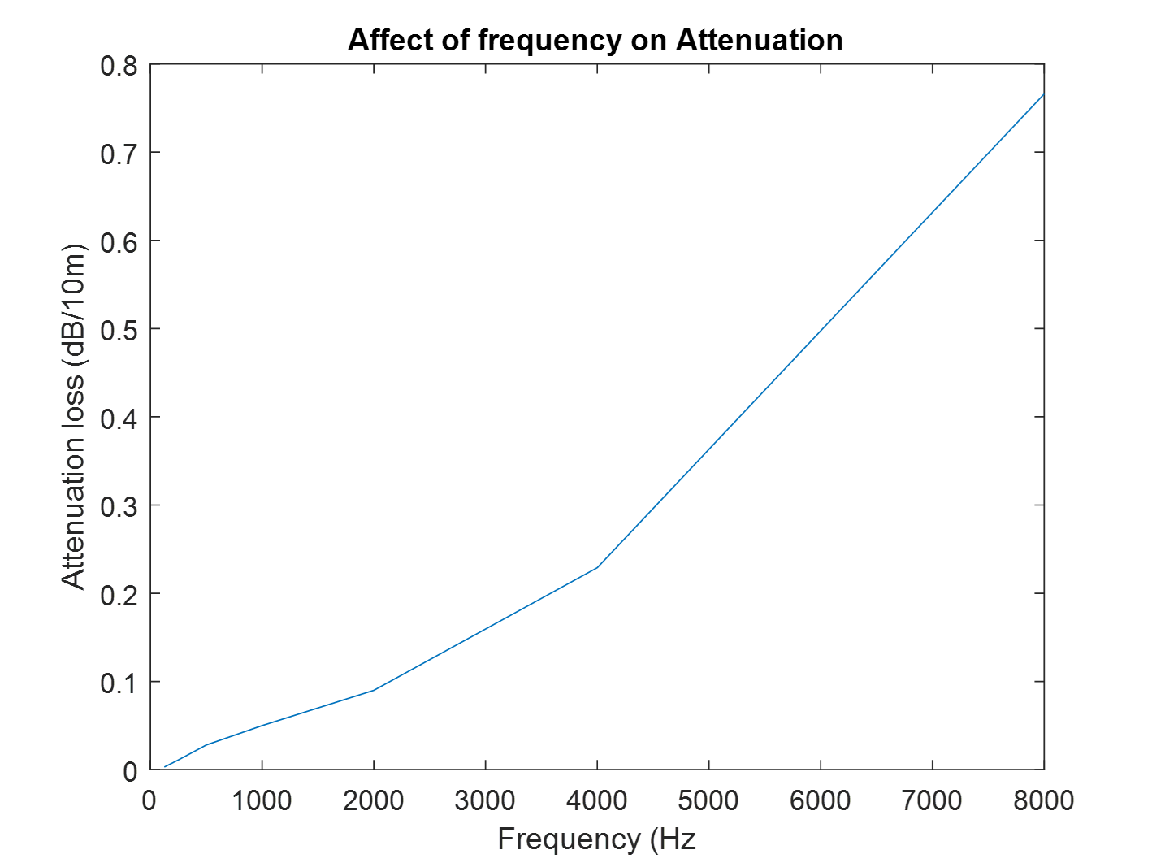
[picture p100: figure]

## Attenuation - Materials

- Materials – Reflective and Absorptive
- Absorption scales with frequency.
- Proportional for Absorptive
- Inversely Proportional for reflective

## Attenuation - Simulations

## Slide 10


## Testing – Code


## Slide 12

## Testing Result

- Max Distance : 18 m
- Max Distance (filtered) : 25 m
- Best Frequency Range : 9kHz – 10 kHz
