pli49/Final-Year-Project/Reports/Final Report/Bill_appendix.tex

\begin{figure}[H]
	\centering
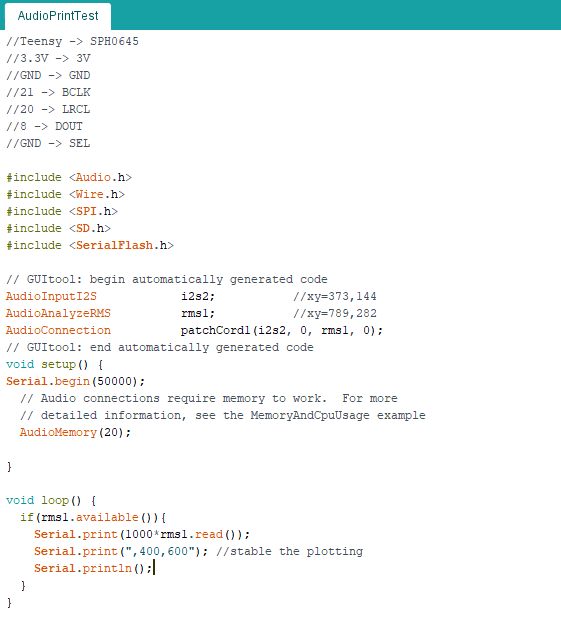
[picture p125: Reports/Final Report/images/RMSS.PNG]
	\noindent
	\caption{Convert the raw output data into RMS form}
	\label{fig:RMSS}
\end{figure}

\begin{figure}[H]
	\centering
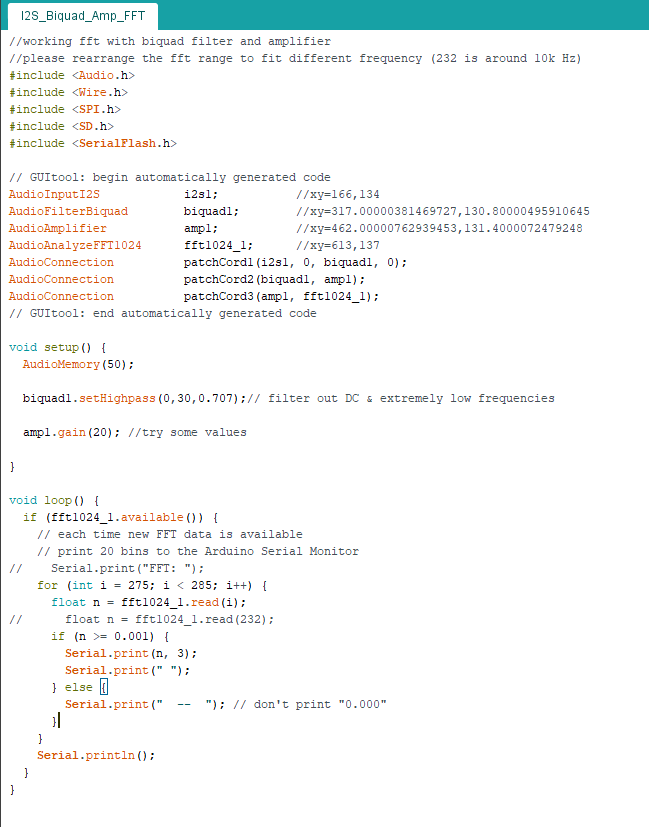
[picture p126: Reports/Final Report/images/I2S_Biquad_Amp_FFT.PNG]
	\noindent
	\caption{FFT out put with IIR biquad filter and amplifier}
	\label{fig:Biquad}
\end{figure}

\begin{figure}[H]
	\centering
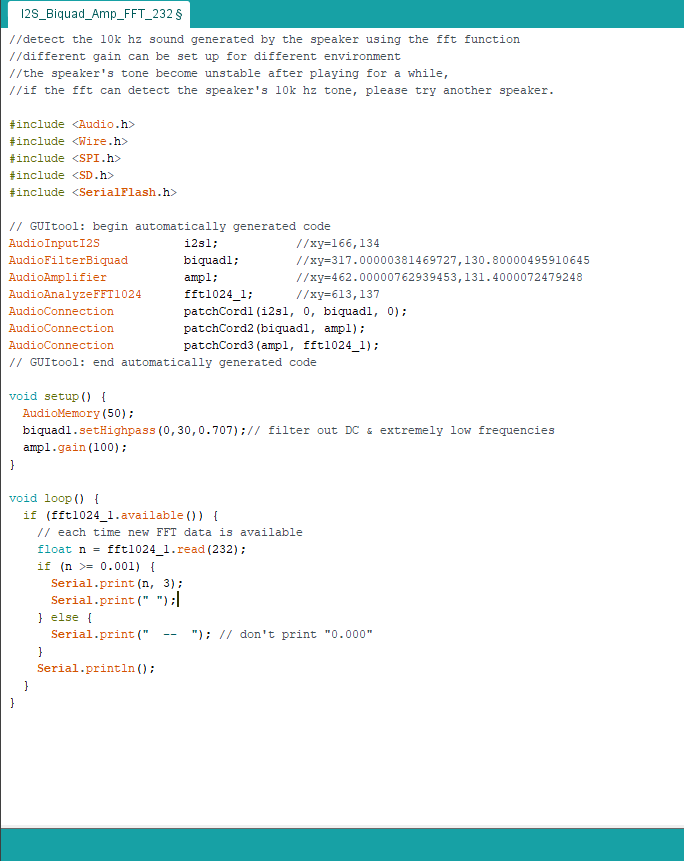
[picture p127: Reports/Final Report/images/10KHz.PNG]
	\noindent
	\caption{FFT out put only 10KHz frequency}
	\label{fig:10KHz}
\end{figure}
