pli49/Final-Year-Project/Sound/FYP/Report/Name.docx

Name | Role
Aryan Srivastava | Sound Signal
Laurence Prins | Speaker
Bill Liu | Microphone
Toby Bourke | 3D Mesh

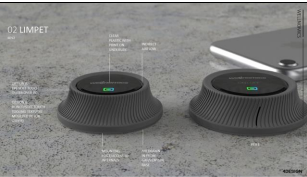
[picture p134: figure]
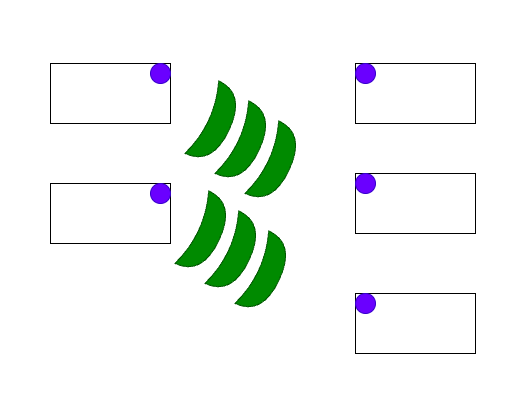
[picture p135: figure]
