pli49/Final-Year-Project/Sound/FYP/Report/PResPhoto.docx

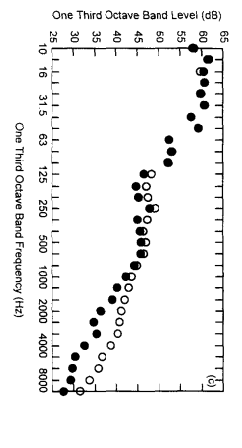
[picture p136: figure]
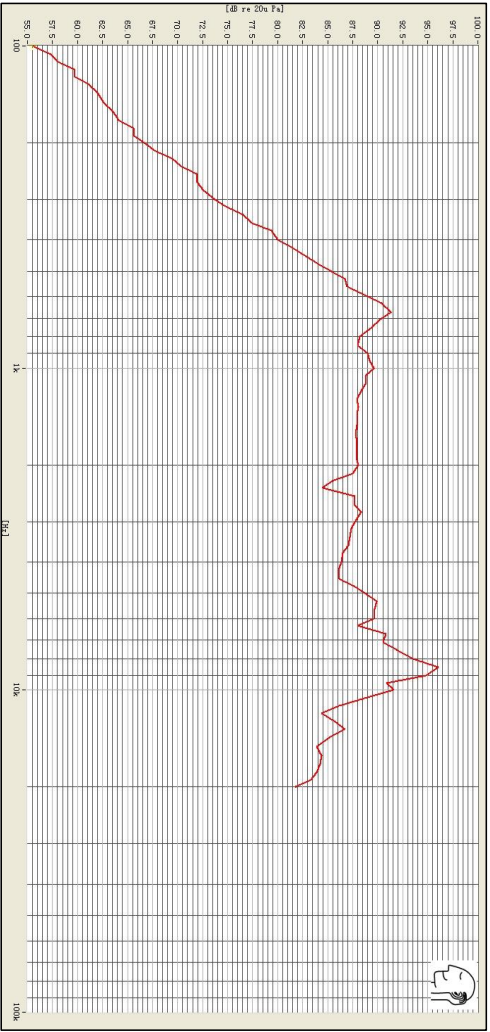
[picture p137: figure]
