pli49/Final-Year-Project/Reports/Final Report/images/Drake.jpg

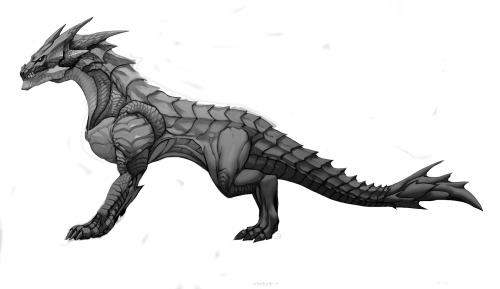
Reports/Final Report/images/Drake.jpg
