pli49/Final-Year-Project/Reports/Final Report/images/QueRow.PNG

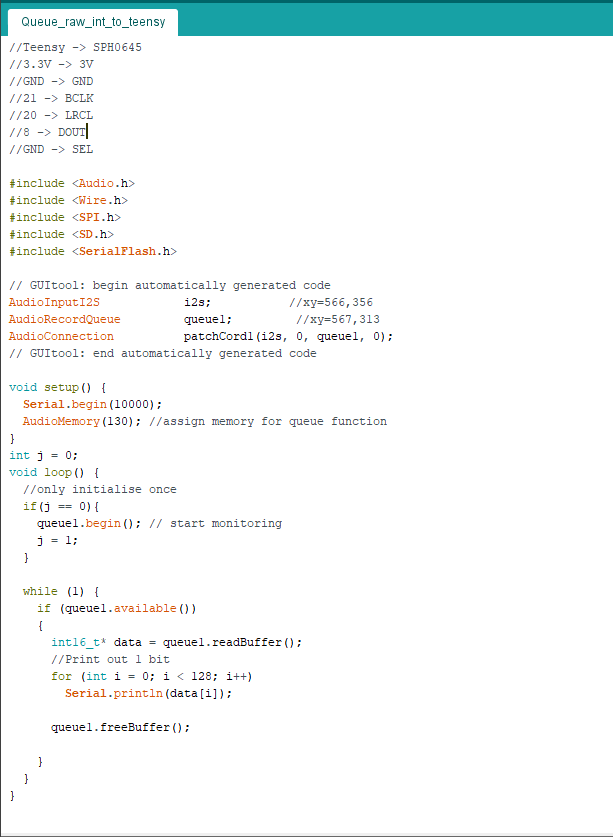
Reports/Final Report/images/QueRow.PNG
