pli49/Final-Year-Project/Reports/Final Report/images/speaker/L_LPF_Alt.png

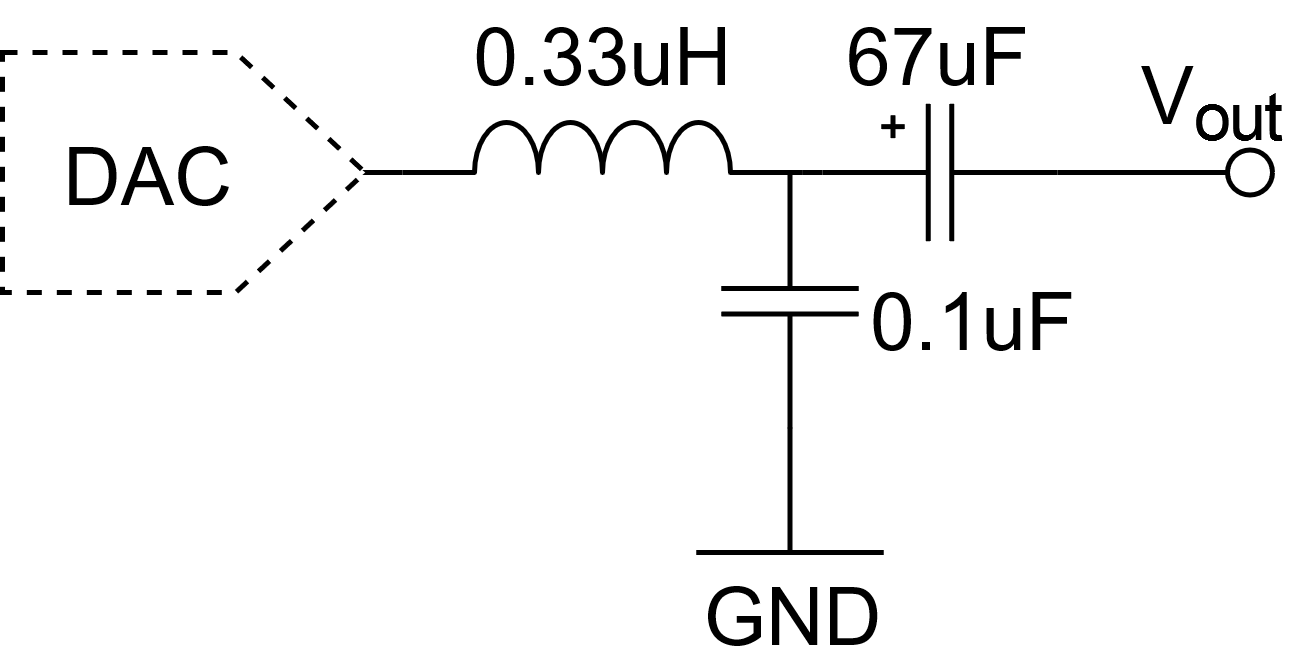
Reports/Final Report/images/speaker/L_LPF_Alt.png
