pli49/Final-Year-Project/Speaker/Speaker Poster/20211008_140330.jpg

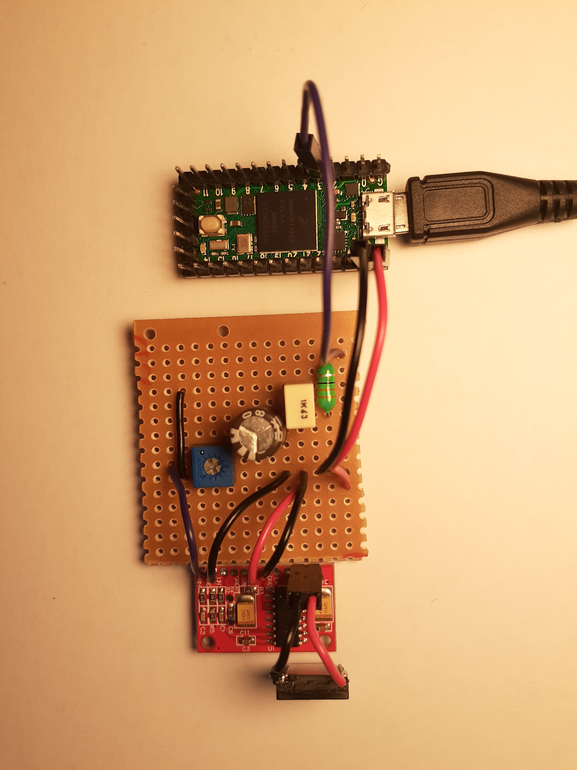
Speaker/Speaker Poster/20211008_140330.jpg
