pli49/Final-Year-Project/Speaker/Speaker Poster/20211008_140349.jpg

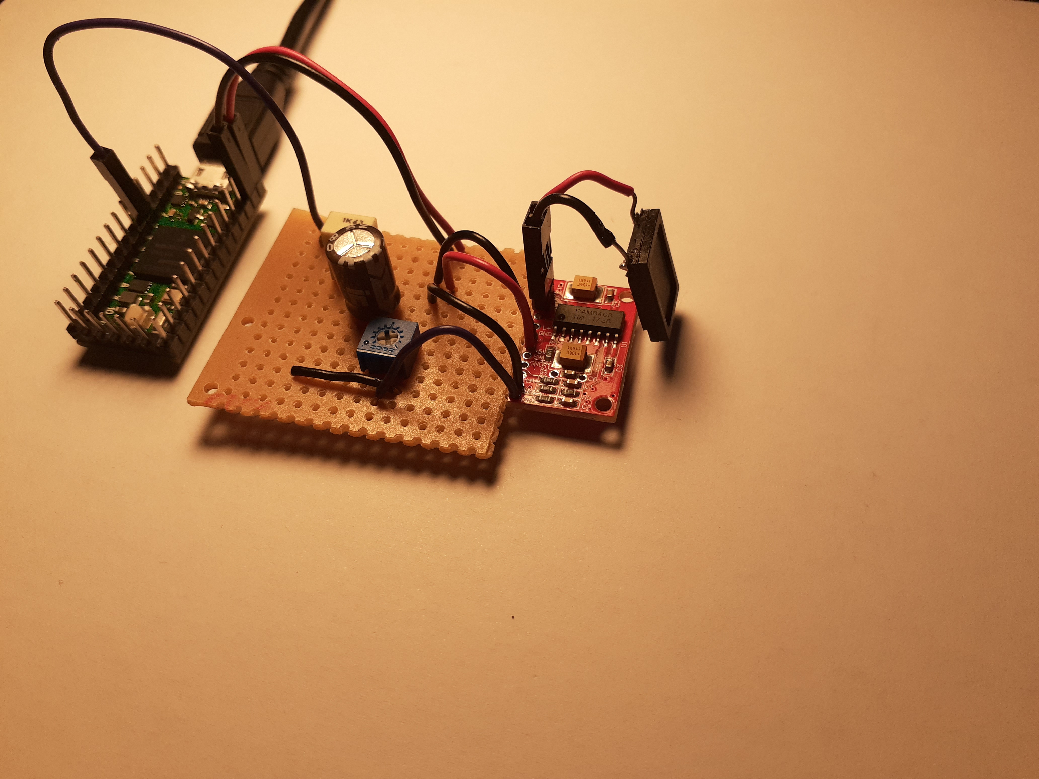
Speaker/Speaker Poster/20211008_140349.jpg
