pli49/Final-Year-Project/Reports/Project Proposal/2_Gantt_Chart_Template.xls

Sheet: Sheet1
Team: |  | Weeks of Project Work
Ref No. | Description | 1 | 2 | 3 | 4 | 5 | 6 | 7 | 8 | 9 | 10 | 11 | 12 | 13 | 14 | 15 | 16 | 17 | 18 | 19 | 20 | 21 | 22 | 23 | 24 | 25 | 26 | 27 | 28 | 29 | 30 | 31
i | Project Selection
ii | Team Organisition
iii | Sponsor's Requirements
iv | Project Planning
A-1 | Preliminary Proposal
A-1 | Final Proposal
1.0 | Research
1.1 | Product & Patent Review
1.2 | Requirements & Specifications
1.3 | Analytical Review
M-1 | Background and Modelling
2.0 | Conceptual Design
2.1 | Concept Brainstorming
2.2 | Concept Generation
2.3 | Risk Analysis
M-1 | Design Selection
3.0 | Modelling & Experiment
3.1 | Modelling 1
3.2 | Modelling 2
3.3 | Experimentation 1
3.4 | Experimentation 2
M-3 | Modelling & Experiments Complete
4.0 | Validation
4.1 | Validation 1
4.2 | Validation 2
4.3 | Validation 3
M-4 | Concept Validated
A-2 | Preliminary Report
A-2 | Final Mid-Year Report
A-3 | Mid-Year Presentation
5.0 | Production
5.1 | Source Materials
5.2 | Manufacture (Workshop)
M-5 | Prototye Built
6.0 | Review & Testing
6.1 | Review
6.2 | Testing
M-6 | Testing Complete
7.0 | Documentation
7.1 | Drawings
7.2 | Experimental Data
7.3 | Computer Simulations
M-7 | Documentation Complete
A-4 | Individual Report
A-5 | Preliminary Team Final Report
A-6 | Poster
A-7 | Presentation
A-5 | Final Team Report
KEY
i | Preliminary Work
A-1 | Assessments
1.0 | Objective
1.1 | Tasks
M-1 | Milestone for Objective 1

Sheet: Sheet3
Item | Cost | Amount | Shipping | Total cost
MEMs(SPH0644LM4H-1) | 1.8 | 4 | 0 | 7.2
Speaker(AS01508MS-SP11-WP-R) | 2.9 | 4 | 20 | 31.6
Tiva board | 27.05 | 4 | 0 | 108.2
 |  |  |  | 147
