pli49/Final-Year-Project/Speaker/Speaker Testing Document/Figures/LM386_Gain_200.png

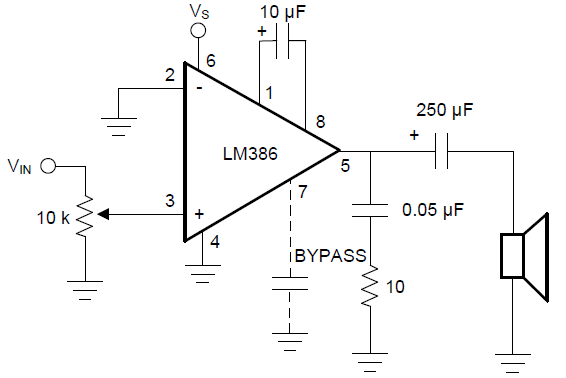
Speaker/Speaker Testing Document/Figures/LM386_Gain_200.png
