pli49/Final-Year-Project/Speaker/Speaker Testing Document/Figures/Waveforms/LC_Filter_Ripple.png

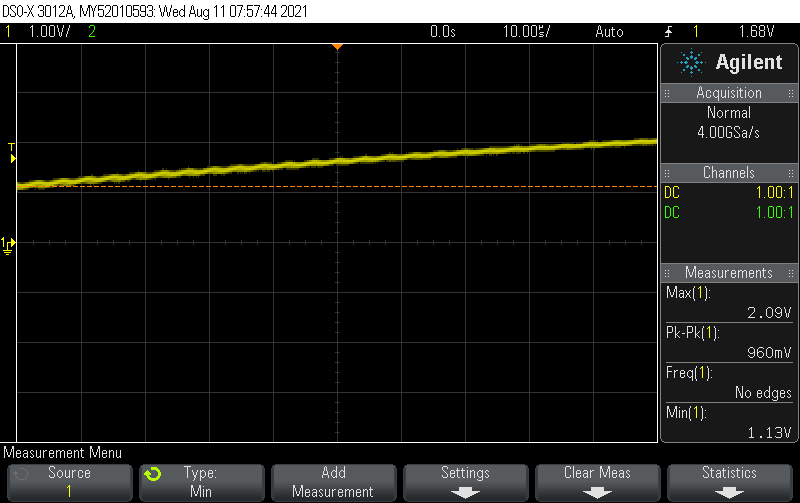
Speaker/Speaker Testing Document/Figures/Waveforms/LC_Filter_Ripple.png
