pli49/Final-Year-Project/Speaker/Speaker Testing Document/Figures/Waveforms/LC_Filtered_Sinewave.png

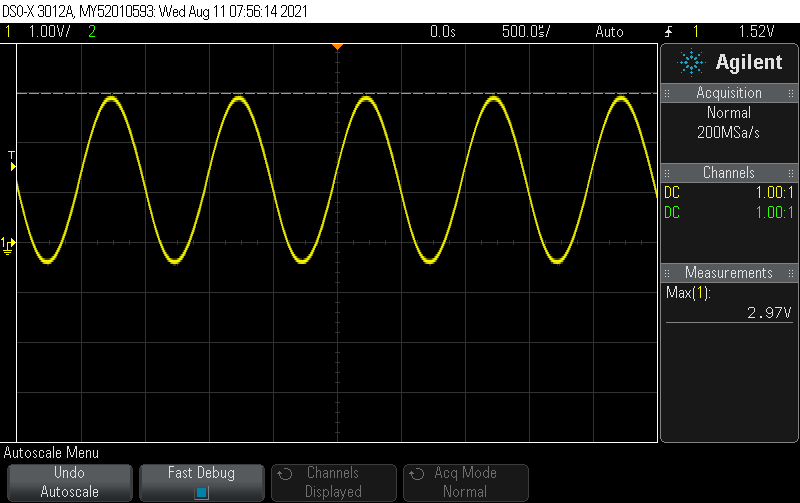
Speaker/Speaker Testing Document/Figures/Waveforms/LC_Filtered_Sinewave.png
