pli49/Final-Year-Project/Speaker/Speaker Testing Document/Figures/Waveforms/Output_Class_AB_Filtered_Ripple.png

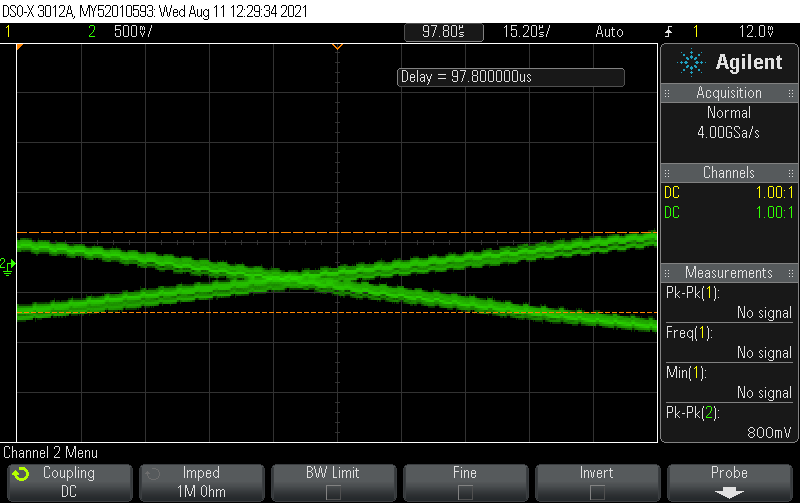
Speaker/Speaker Testing Document/Figures/Waveforms/Output_Class_AB_Filtered_Ripple.png
