pli49/Final-Year-Project/Speaker/Speaker Testing Document/Figures/Waveforms/Output_Class_D_Filtered_No_Input_Filter.png

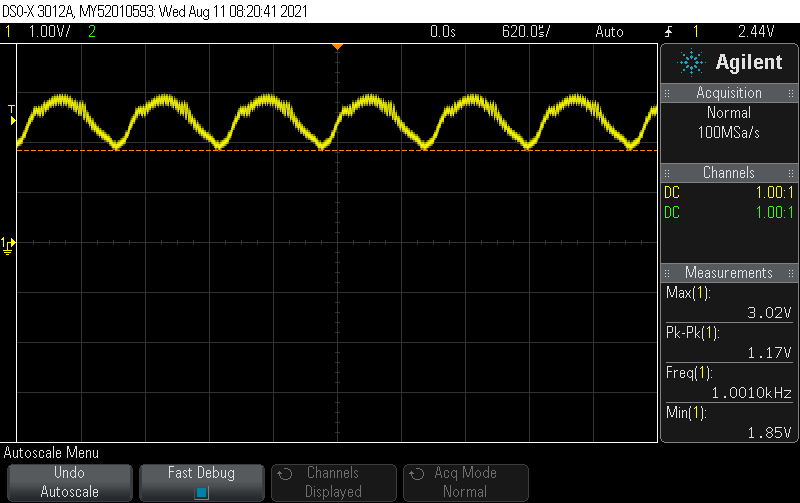
Speaker/Speaker Testing Document/Figures/Waveforms/Output_Class_D_Filtered_No_Input_Filter.png
