pli49/Final-Year-Project/Speaker/Speaker Testing Document/Figures/Waveforms/Output_Class_D_Filtered_Reduced_Input.png

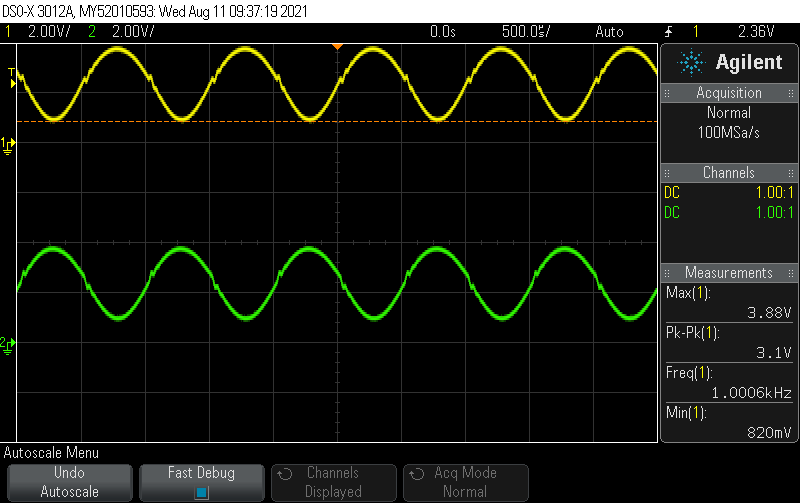
Speaker/Speaker Testing Document/Figures/Waveforms/Output_Class_D_Filtered_Reduced_Input.png
