pli49/Final-Year-Project/Speaker/Speaker Testing Document/Figures/Waveforms/Output_Class_D_Unfiltered_Both_Zoomed.png

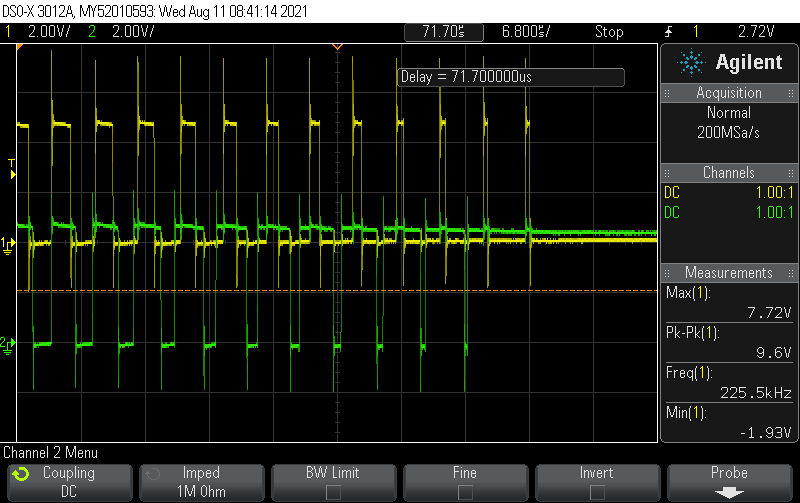
Speaker/Speaker Testing Document/Figures/Waveforms/Output_Class_D_Unfiltered_Both_Zoomed.png
