pli49/Final-Year-Project/Speaker/Speaker Testing Document/Figures/Waveforms/scope_10.png

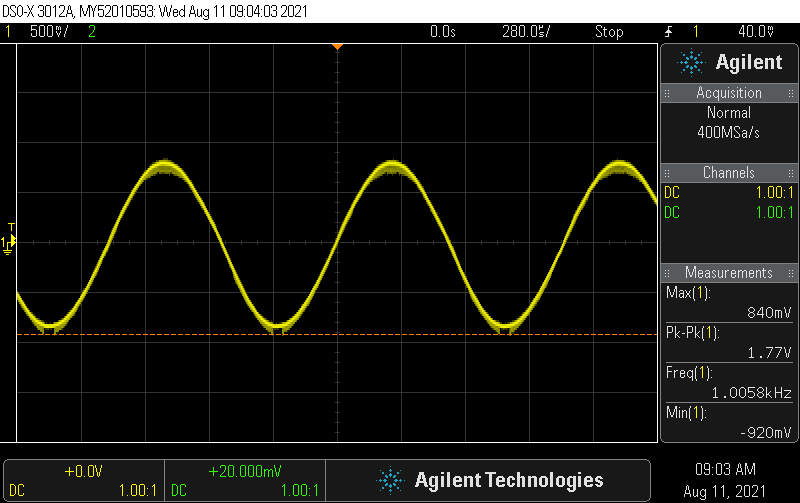
Speaker/Speaker Testing Document/Figures/Waveforms/scope_10.png
