pli49/Final-Year-Project/(list of files, drawings)

Other design files:
Pengcheng-Liu-Mic-part/Breakout board/MEMs_Breakout_Board/MEMs_Breakout_Board.PcbDoc
Pengcheng-Liu-Mic-part/Breakout board/MEMs_Breakout_Board/MEMs_Breakout_Board.PrjPcb
Pengcheng-Liu-Mic-part/Breakout board/MEMs_Breakout_Board/MEMs_Breakout_Board.SchDoc
