pli49/Final-Year-Project/Pengcheng-Liu-Mic-part/Code/I2S_FFT/I2S_FFT.ino

// doesn't work well

#include <Audio.h>
#include <Wire.h>
#include <SPI.h>
#include <SD.h>
#include <SerialFlash.h>

// Create the Audio components.  These should be created in the
// order data flows, inputs/sources -> processing -> outputs
//
AudioInputI2S          audioInput;         // audio shield: mic or line-in
AudioAnalyzeFFT1024    myFFT;
AudioOutputI2S         audioOutput;        // audio shield: headphones & line-out
AudioConnection patchCord1(audioInput, 0, myFFT, 0);


void setup() {
  // Audio connections require memory to work.  For more
  // detailed information, see the MemoryAndCpuUsage example
  AudioMemory(12);
}

void loop() {
  float n;
  int i;

  if (myFFT.available()) {
    // each time new FFT data is available
    // print it all to the Arduino Serial Monitor
    Serial.print("FFT: ");
    for (i=0; i<40; i++) {
      n = myFFT.read(i);
      if (n >= 0.01) {
        Serial.print(n);
        Serial.print(" ");
      } else {
        Serial.print("  -  "); // don't print "0.00"
      }
    }
    Serial.println();
  }
}
